deliacremene/smartgarden/data/black1.png

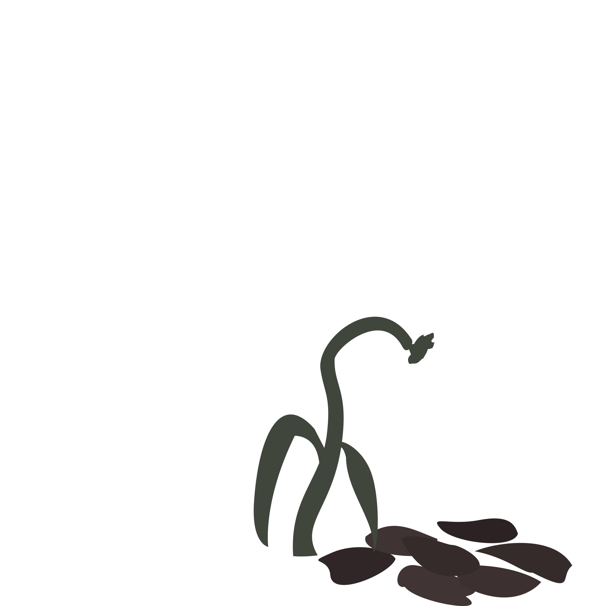
data/black1.png
