deliacremene/smartgarden/data/black2.png

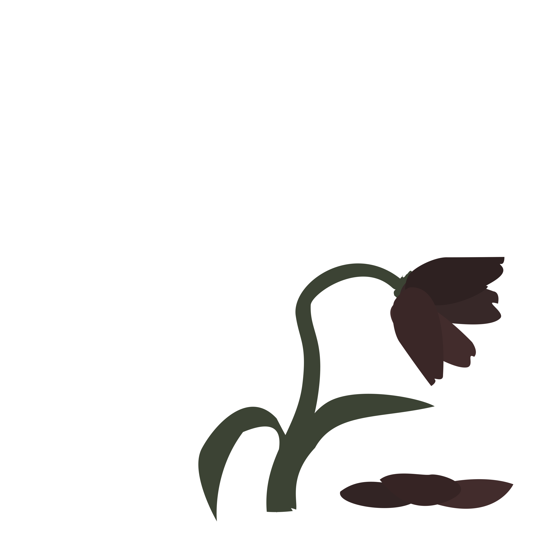
data/black2.png
