deliacremene/smartgarden/data/black3.png

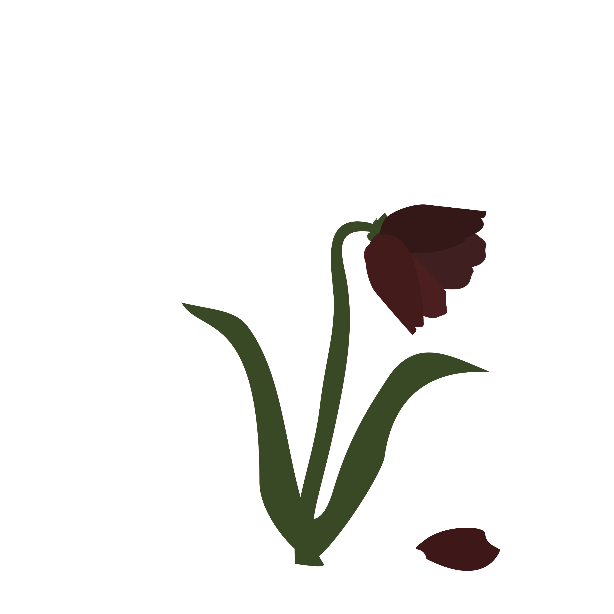
data/black3.png
