deliacremene/smartgarden/data/black4.png

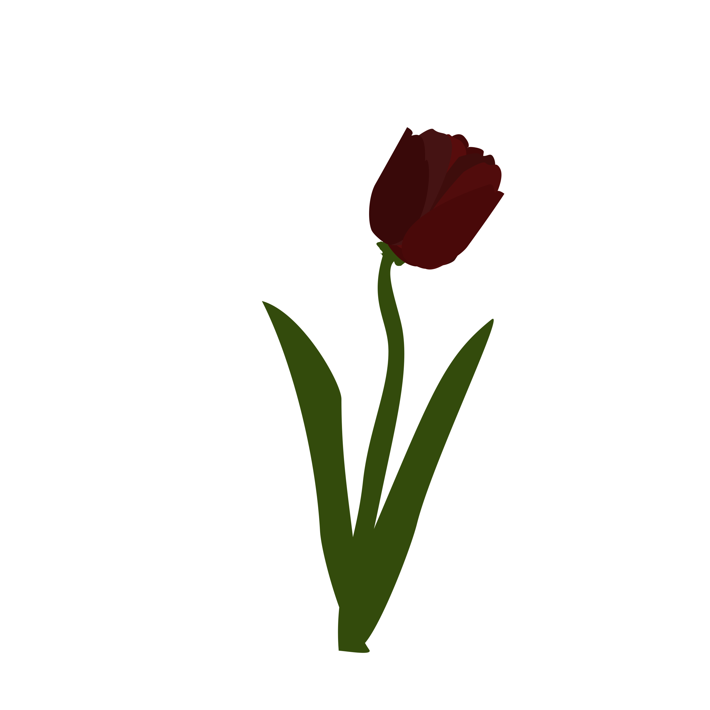
data/black4.png
